klaus-liebler/esp32_octal_wled/esp32_octal_wled.kicad_pcb

## KiCad design esp32_octal_wled.kicad_pcb (2026-01-29)

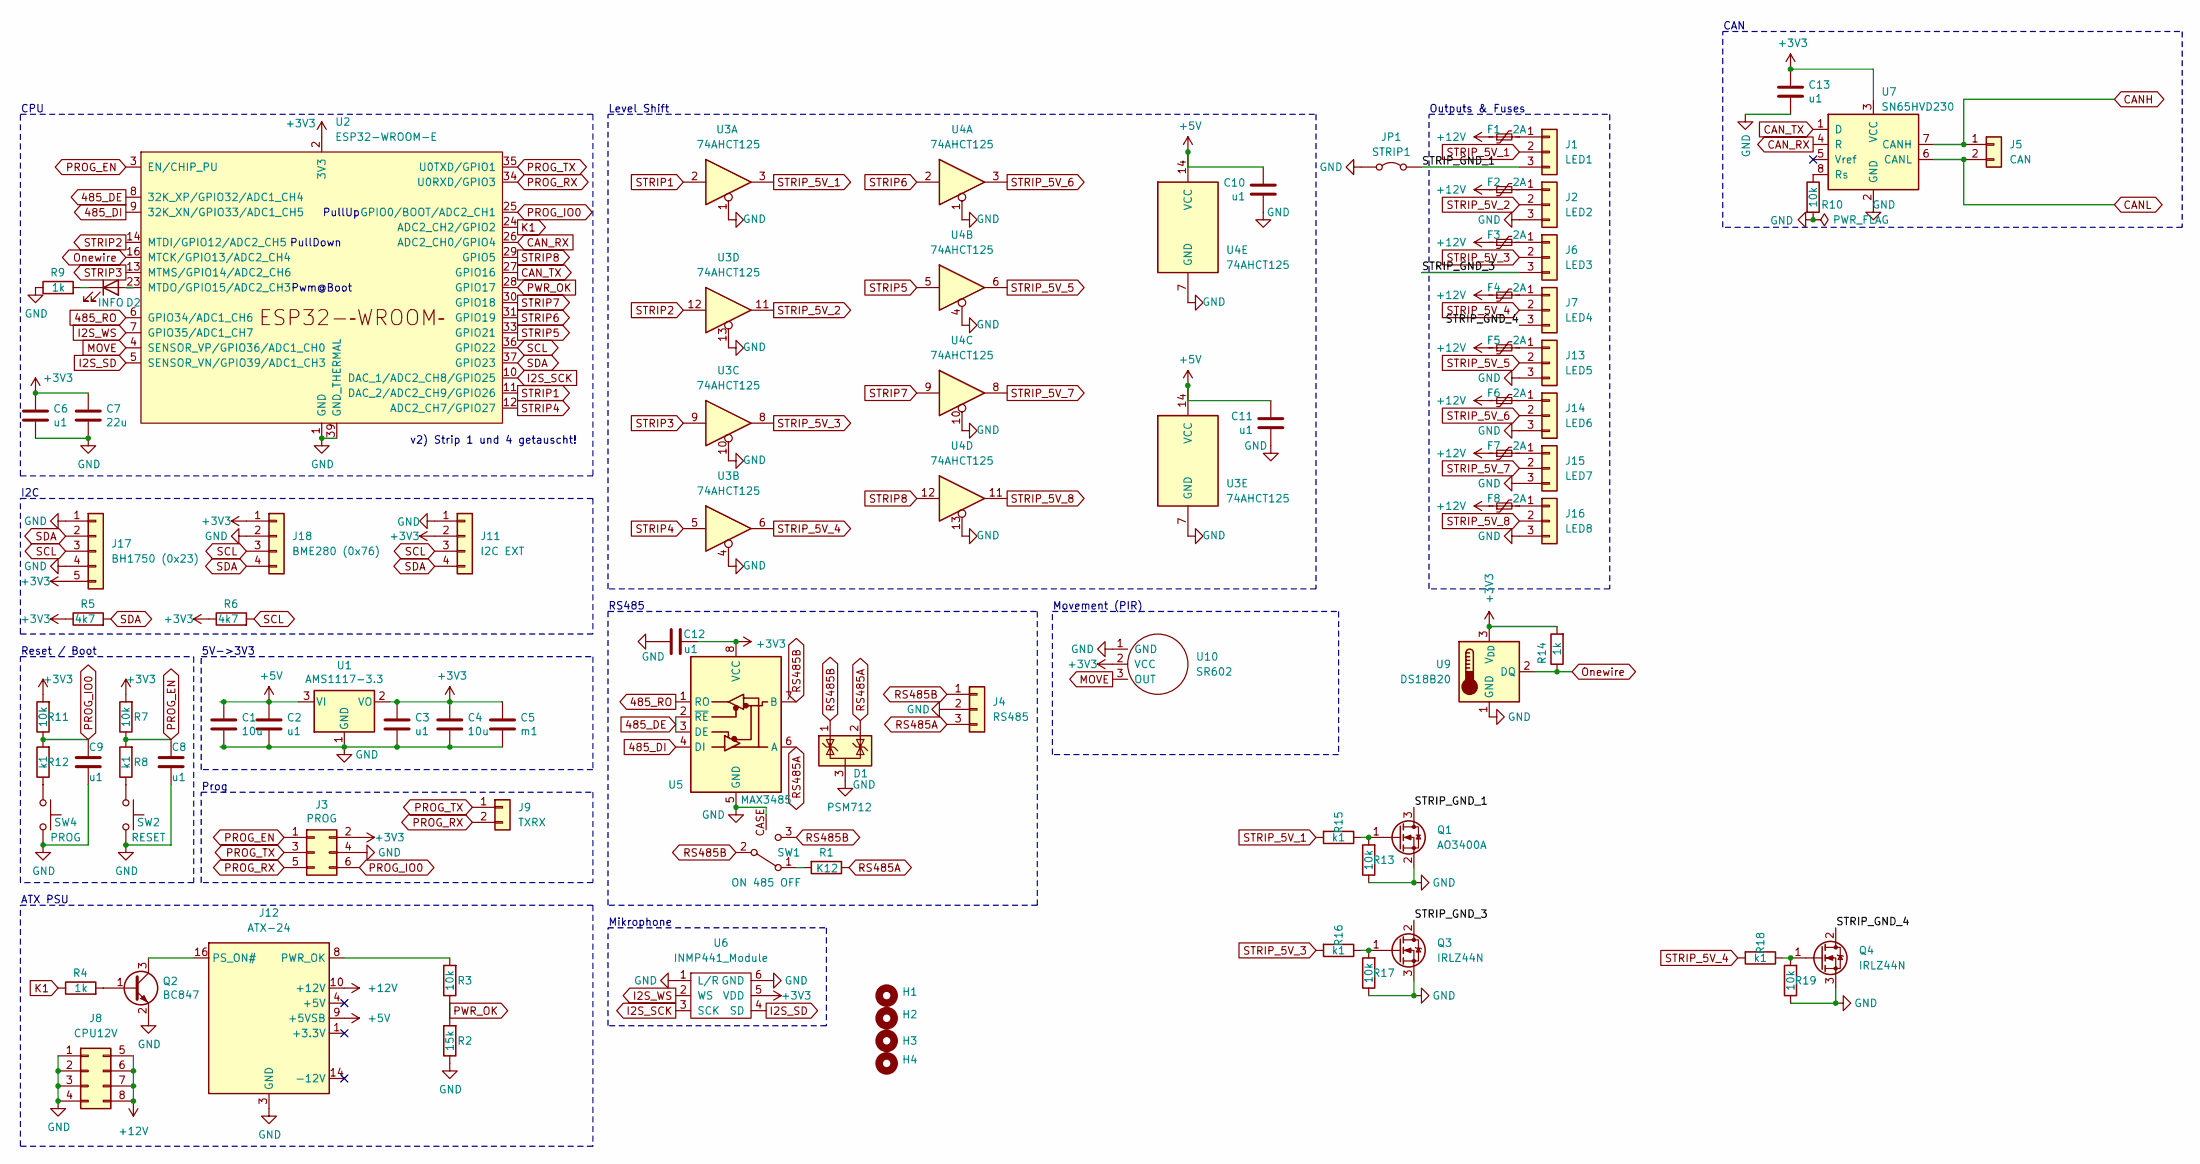
[picture p1: schematic esp32_octal_wled.kicad_sch]

Parts:
C1, C4: 10u; C_0805_2012Metric_Pad1.18x1.45mm_HandSolder
C2: u1; C_0805_2012Metric_Pad1.18x1.45mm_HandSolder; JLCPCB C19702
C3, C8, C9, C12, C13: u1; C_0805_2012Metric_Pad1.18x1.45mm_HandSolder
C5: m1; C_1206_3216Metric_Pad1.33x1.80mm_HandSolder; JLCPCB C15008
C6, C10, C11: u1; C_0805_2012Metric_Pad1.18x1.45mm_HandSolder; JLCPCB C1525
C7: 22u; C_0805_2012Metric_Pad1.18x1.45mm_HandSolder; JLCPCB C59461
D1: PSM712; SOT-23_Handsoldering
D2: INFO; LED_0805_2012Metric_Pad1.15x1.40mm_HandSolder
F1, F2, F3, F4, F5, F6, F7, F8: 2A; Fuse_2920_7451Metric_Pad2.10x5.45mm_HandSolder
H1, H2, H3, H4: MountingHole_3.2mm_M3
J1: LED1; PhoenixContact_MC_1,5_3-G-3.5_1x03_P3.50mm_Horizontal_small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
J2: LED2; PhoenixContact_MC_1,5_3-G-3.5_1x03_P3.50mm_Horizontal_small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
J3: PROG; IDC_2x03_P1.27mm_Vertical
J4: RS485; PhoenixContact_MC_1,5_3-G-3.5_1x03_P3.50mm_Horizontal_small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
J5: CAN; PhoenixContact_MCV_1,5_2-G-3.5_1x02_P3.50mm_Vertical
J6: LED3; PhoenixContact_MC_1,5_3-G-3.5_1x03_P3.50mm_Horizontal_small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
J7: LED4; PhoenixContact_MC_1,5_3-G-3.5_1x03_P3.50mm_Horizontal_small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
J8: CPU12V; Molex_Mini-Fit_Jr_5569-08A2_2x04_P4.20mm_Horizontal
J9: TXRX; TestPoint_2Pads_Pitch2.54mm_Drill0.8mm
J11: I2C EXT; JST_XH_S4B-XH-A-1_1x04_P2.50mm_Horizontal_SmallerCourtyard
J12: ATX-24; Molex_Mini-Fit_Jr_5569-24A2_2x12_P4.20mm_Horizontal
J13: LED5; PhoenixContact_MC_1,5_3-G-3.5_1x03_P3.50mm_Horizontal_small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
J14: LED6; PhoenixContact_MC_1,5_3-G-3.5_1x03_P3.50mm_Horizontal_small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
J15: LED7; PhoenixContact_MC_1,5_3-G-3.5_1x03_P3.50mm_Horizontal_small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
J16: LED8; PhoenixContact_MC_1,5_3-G-3.5_1x03_P3.50mm_Horizontal_small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
J17: BH1750 (0x23); PinSocket_1x05_P2.54mm_Vertical
J18: BME280 (0x76); PinSocket_1x04_P2.54mm_Vertical
JP1: STRIP1; SolderJumper-2_P1.3mm_Bridged2Bar_Pad1.0x1.5mm
Q1: AO3400A; SOT-23_Handsoldering
Q2: BC847; SOT-23_Handsoldering
Q3, Q4: IRLZ44N; TO-220-3_Vertical
R1: K12; R_1206_3216Metric_Pad1.30x1.75mm_HandSolder
R2: 15k; R_0805_2012Metric_Pad1.20x1.40mm_HandSolder
R3, R7, R10, R11, R13, R17, R19: 10k; R_0805_2012Metric_Pad1.20x1.40mm_HandSolder
R4, R9, R14: 1k; R_0805_2012Metric_Pad1.20x1.40mm_HandSolder
R5, R6: 4k7; R_0805_2012Metric_Pad1.20x1.40mm_HandSolder
R8, R12, R15, R16, R18: k1; R_0805_2012Metric_Pad1.20x1.40mm_HandSolder
SW1: ON 485 OFF; SW_SPDT_PCM12_handsolder
SW2: RESET; SW_SPST_TL3342_smaller_handsolder
SW4: PROG; SW_SPST_TL3342_smaller_handsolder
U1: AMS1117-3.3; SOT-223-3_TabPin2
U2: ESP32-WROOM-E; ESP32-WROOM-32_HANDSOLDER
U3, U4: 74AHCT125; SOIC-14_3.9x8.7mm_P1.27mm_handsolder
U5: MAX3485; SOIC-8_3.9x4.9mm_P1.27mm_handsolder
U6: INMP441_Module
U7: SN65HVD230; SOIC-8_3.9x4.9mm_P1.27mm_handsolder
U9: DS18B20; TO-92L_HandSolder
U10: SR602; PIR_Sensor_SR602

Connections:
485_DE: U2.8 (32K_XP/GPIO32/ADC1_CH4), U5.2 (~RE), U5.3 (DE)
485_DI: U2.9 (32K_XN/GPIO33/ADC1_CH5), U5.4 (DI)
485_RO: U2.6 (GPIO34/ADC1_CH6), U5.1 (RO)
+3V3: C3.1, C4.1, C5.1, C6.1, C7.1, C12.1, C13.1, J3.2, J11.2, J17.5, J18.1, R5.1, R6.1, R7.2, R11.2, R14.2, U1.2 (VO), U2.2 (3V3), U5.8 (VCC), U6.5 (VDD), U7.3 (VCC), U9.3 (V_{DD}), U10.2 (VCC)
+5V: C1.1, C2.1, C10.1, C11.1, J12.9 (+5VSB), U1.3 (VI), U3.14 (VCC), U4.14 (VCC)
+12V: F1.1, F2.1, F3.1, F4.1, F5.1, F6.1, F7.1, F8.1, J8.5, J8.6, J8.7, J8.8, J12.10 (+12V), J12.11 (+12V)
/STRIP_GND_1: J1.3, JP1.2 (B), Q1.3 (D)
/STRIP_GND_3: J6.3, Q3.2 (D)
/STRIP_GND_4: J7.3, Q4.2 (D)
CANH: J5.1, U7.7 (CANH)
CANL: J5.2, U7.6 (CANL)
CAN_RX: U2.26 (ADC2_CH0/GPIO4), U7.4 (R)
CAN_TX: U2.27 (GPIO16), U7.1 (D)
GND: C1.2, C2.2, C3.2, C4.2, C5.2, C6.2, C7.2, C8.2, C9.2, C10.2, C11.2, C12.2, C13.2, D1.3 (A), J2.3, J3.4, J4.2, J8.1, J8.2, J8.3, J8.4, J11.1, J12.3 (GND), J12.5 (GND), J12.7 (GND), J12.15 (GND), J12.17 (GND), J12.18 (GND), J12.19 (GND), J12.24 (GND), J13.3, J14.3, J15.3, J16.3, J17.1, J17.4, J18.2, JP1.1 (A), Q1.2 (S), Q2.2 (E), Q3.3 (S), Q4.3 (S), R2.1, R9.1, R10.2, R13.1, R17.1, R19.1, SW1.CASE, SW2.2, SW4.2, U1.1 (GND), U2.1 (GND), U2.15 (GND), U2.38 (GND), U2.39 (GND_THERMAL), U3.1, U3.4, U3.7 (GND), U3.10, U3.13, U4.1, U4.4, U4.7 (GND), U4.10, U4.13, U5.5 (GND), U6.1 (L/R), U6.6 (GND), U7.2 (GND), U9.1 (GND), U10.1 (GND)
I2S_SCK: U2.10 (DAC_1/ADC2_CH8/GPIO25), U6.3 (SCK)
I2S_SD: U2.5 (SENSOR_VN/GPIO39/ADC1_CH3), U6.4 (SD)
I2S_WS: U2.7 (GPIO35/ADC1_CH7), U6.2 (WS)
K1: R4.1, U2.24 (ADC2_CH2/GPIO2)
MOVE: U2.4 (SENSOR_VP/GPIO36/ADC1_CH0), U10.3 (OUT)
unnamed: D2.2 (A), U2.23 (MTDO/GPIO15/ADC2_CH3)
unnamed: D2.1 (K), R9.2
unnamed: F1.2, J1.1
unnamed: F2.2, J2.1
unnamed: F3.2, J6.1
unnamed: F4.2, J7.1
unnamed: J12.16 (PS_ON#), Q2.3 (C)
unnamed: J12.8 (PWR_OK), R3.2
unnamed: F5.2, J13.1
unnamed: F6.2, J14.1
unnamed: F7.2, J15.1
unnamed: F8.2, J16.1
unnamed: Q1.1 (G), R13.2, R15.1
unnamed: Q2.1 (B), R4.2
unnamed: Q3.1 (G), R16.1, R17.2
unnamed: Q4.1 (G), R18.1, R19.2
unnamed: R8.1, SW2.1
unnamed: R12.1, SW4.1
unnamed: R1.2, SW1.1 (A)
unnamed: R10.1, U7.8 (Rs)
Onewire: R14.1, U2.16 (MTCK/GPIO13/ADC2_CH4), U9.2 (DQ)
PROG_EN: C8.1, J3.1, R7.1, R8.2, U2.3 (EN/CHIP_PU)
PROG_IO0: C9.1, J3.6, R11.1, R12.2, U2.25 (GPIO0/BOOT/ADC2_CH1)
PROG_RX: J3.5, J9.2, U2.34 (U0RXD/GPIO3)
PROG_TX: J3.3, J9.1, U2.35 (U0TXD/GPIO1)
PWR_OK: R2.2, R3.1, U2.28 (GPIO17)
RS485A: D1.2 (K), J4.3, R1.1, U5.6 (A)
RS485B: D1.1 (K), J4.1, SW1.2 (B), SW1.3 (C), U5.7 (B)
SCL: J11.3, J17.3, J18.3, R6.2, U2.36 (GPIO22)
SDA: J11.4, J17.2, J18.4, R5.2, U2.37 (GPIO23)
STRIP1: U2.11 (DAC_2/ADC2_CH9/GPIO26), U3.2
STRIP2: U2.14 (MTDI/GPIO12/ADC2_CH5), U3.12
STRIP3: U2.13 (MTMS/GPIO14/ADC2_CH6), U3.9
STRIP4: U2.12 (ADC2_CH7/GPIO27), U3.5
STRIP5: U2.33 (GPIO21), U4.5
STRIP6: U2.31 (GPIO19), U4.2
STRIP7: U2.30 (GPIO18), U4.9
STRIP8: U2.29 (GPIO5), U4.12
STRIP_5V_1: J1.2, R15.2, U3.3
STRIP_5V_2: J2.2, U3.11
STRIP_5V_3: J6.2, R16.2, U3.8
STRIP_5V_4: J7.2, R18.2, U3.6
STRIP_5V_5: J13.2, U4.6
STRIP_5V_6: J14.2, U4.3
STRIP_5V_7: J15.2, U4.8
STRIP_5V_8: J16.2, U4.11

Notes on the sheet:
v2) Strip 1 und 4 getauscht!
Movement (PIR)
CPU
Outputs & Fuses
CAN
Mikrophone
Level Shift
Prog
PullDown
Pwm@Boot
Reset / Boot
PullUp
ATX PSU
5V->3V3
I2C
RS485

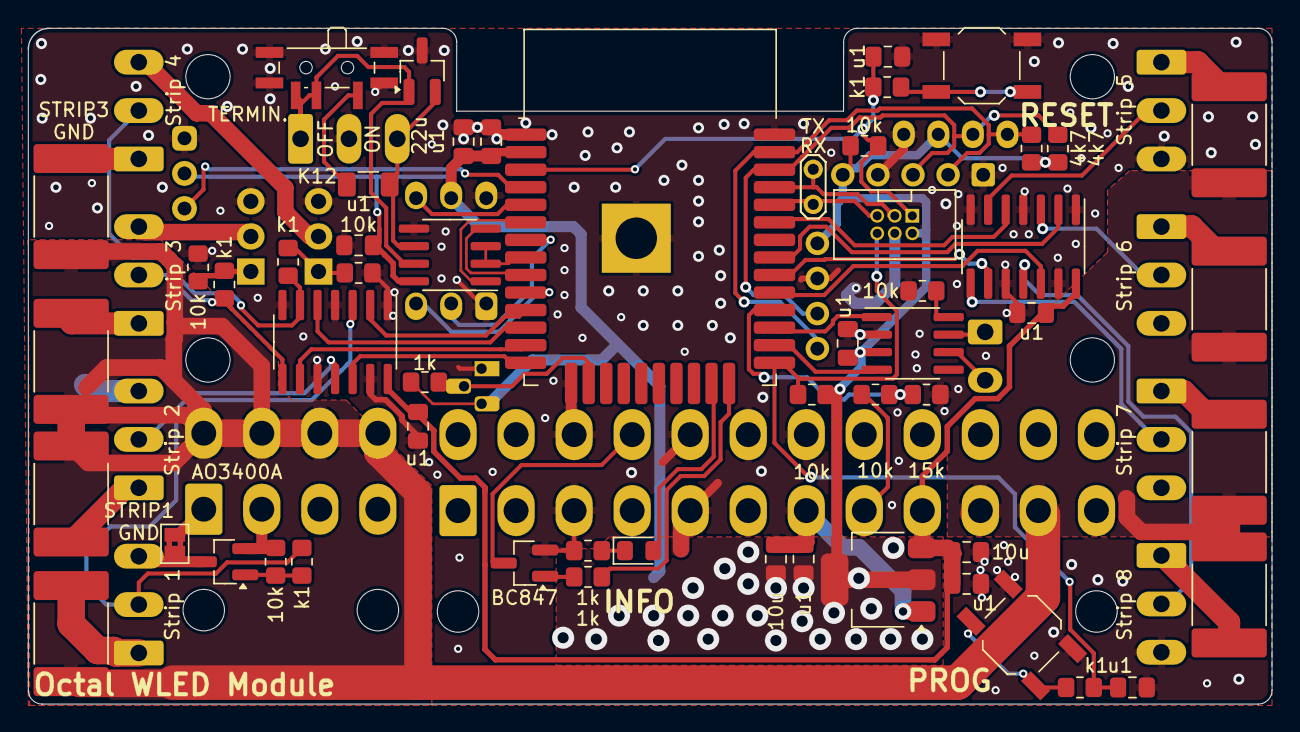
[picture p2: board esp32_octal_wled.kicad_pcb from above]

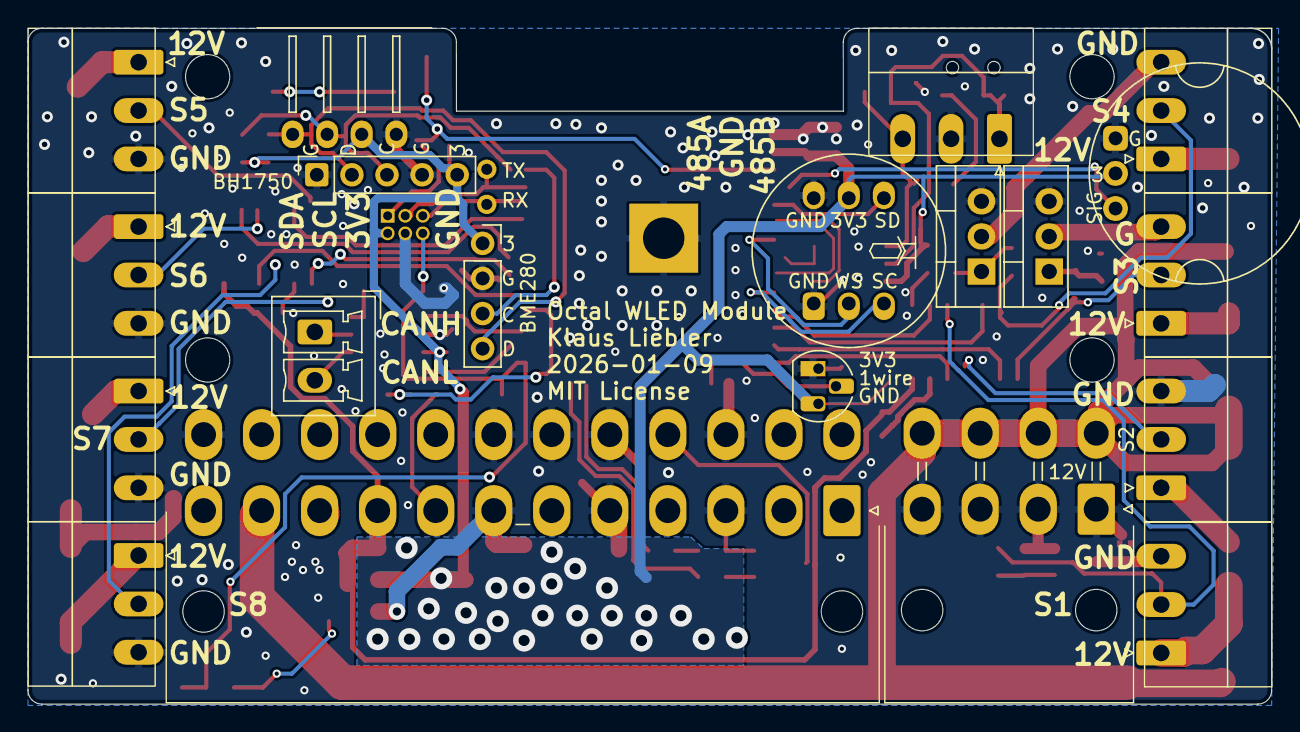
[picture p3: board esp32_octal_wled.kicad_pcb from below]

Board: 2 copper layers, 90.0 x 48.9 mm, 79 parts (20 on the bottom side), 65 nets.
