klaus-liebler/esp32_octal_wled/(commit log)

2024-11-15 As ordered at JLCPCB
    [BOM-esp32_octal_wled.csv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]
2025-01-09 Two layer PCB, other PCB format
    [esp32_octal_wled.kicad_pcb, esp32_octal_wled.kicad_sch]
2025-01-14 OctalWLED as ordered @ JLCPCB
    [CPL-esp32_octal_wled.csv, esp32_octal_wled-CuBottom.gbr, esp32_octal_wled-CuTop.gbr, esp32_octal_wled-EdgeCuts.gbr, esp32_octal_wled-MaskBottom.gbr, esp32_octal_wled-MaskTop.gbr, esp32_octal_wled-NPTH.drl, esp32_octal_wled-PTH.drl]
2025-02-04 Minor updates
    [esp32_octal_wled.kicad_pcb]
2025-04-25 Updated to KiCad 9
    [esp32_octal_wled.kicad_pcb, esp32_octal_wled.kicad_sch]
2025-12-01 Minor fixes
    [esp32_octal_wled.kicad_pcb, esp32_octal_wled.kicad_sch]
2026-01-29 New Version as ordered @ JLCPCB
    [BOM-esp32_octal_wled.csv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]
