klaus-liebler/esp32_octal_wled/(notices)

Notices in the files:
esp32_octal_wled.kicad_pcb:
MIT License
